Gennady-Kudinov/PA-EW3MM-1kw-TUNER-1kw/README.md

# PA-EW3MM-1kw-TUNER-1kw
  This project of a 1 kW power amplifier was developed by Sergey EW3MM. This project is very easy to repeat, practically does not require special settings. It is very simple and reliable.
You can watch how this power amplifier was assembled and how it works on the channel: 
https://rutube.ru/channel/23993242/videos/
@pa_tuner_1000wt
https://www.youtube.com/@tulacamera/videos

It would be good if programmers join this project and add new features to this power amplifier.
[amp_last.pdf](https://github.com/user-attachments/files/19566176/amp_last.pdf)
