Gennady-Kudinov/PA-EW3MM-1kw-TUNER-1kw/amp_last.pdf

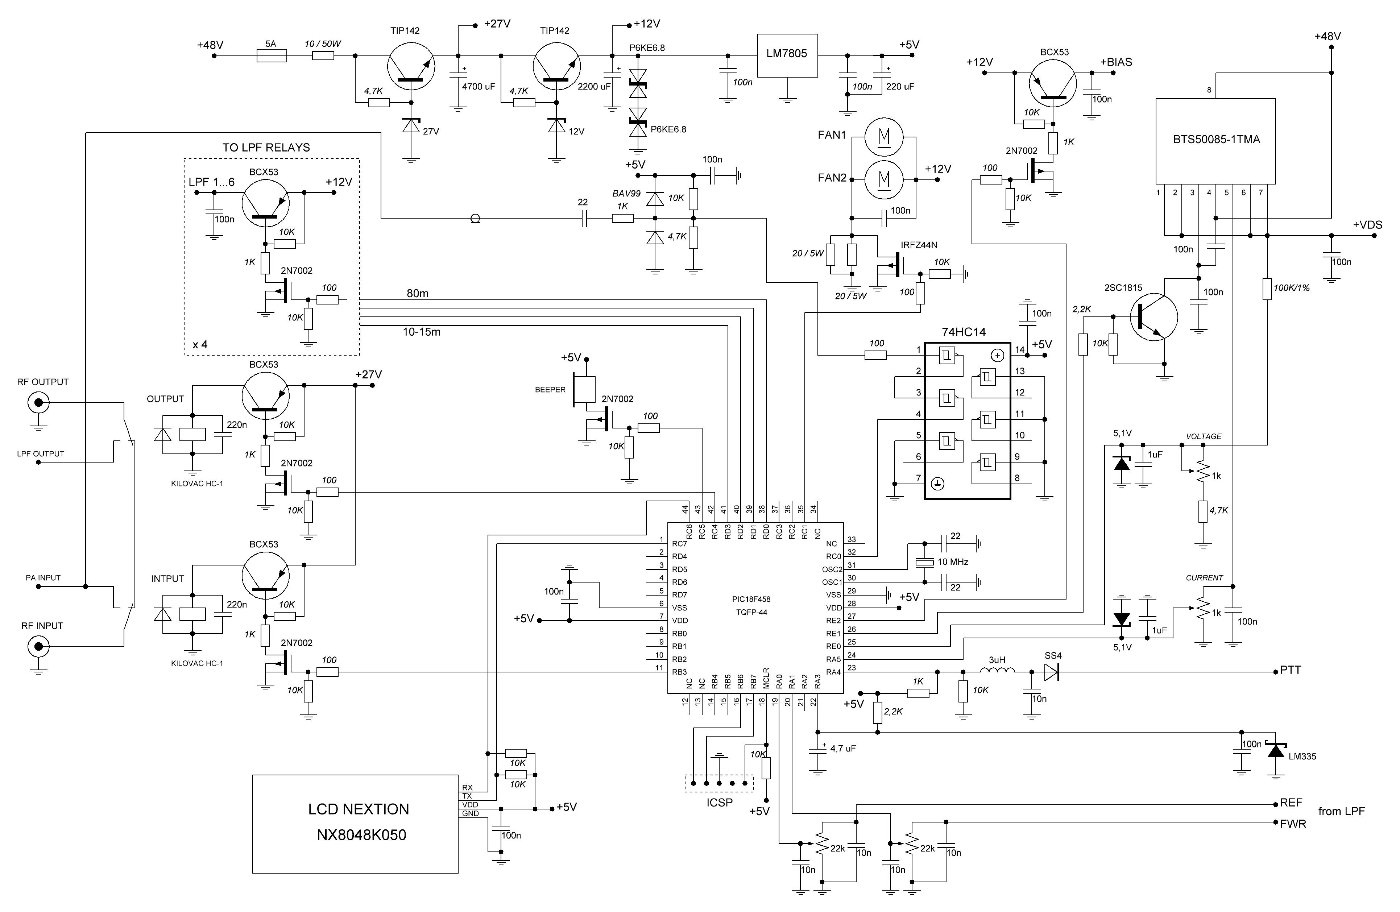
[picture p1: page 1]
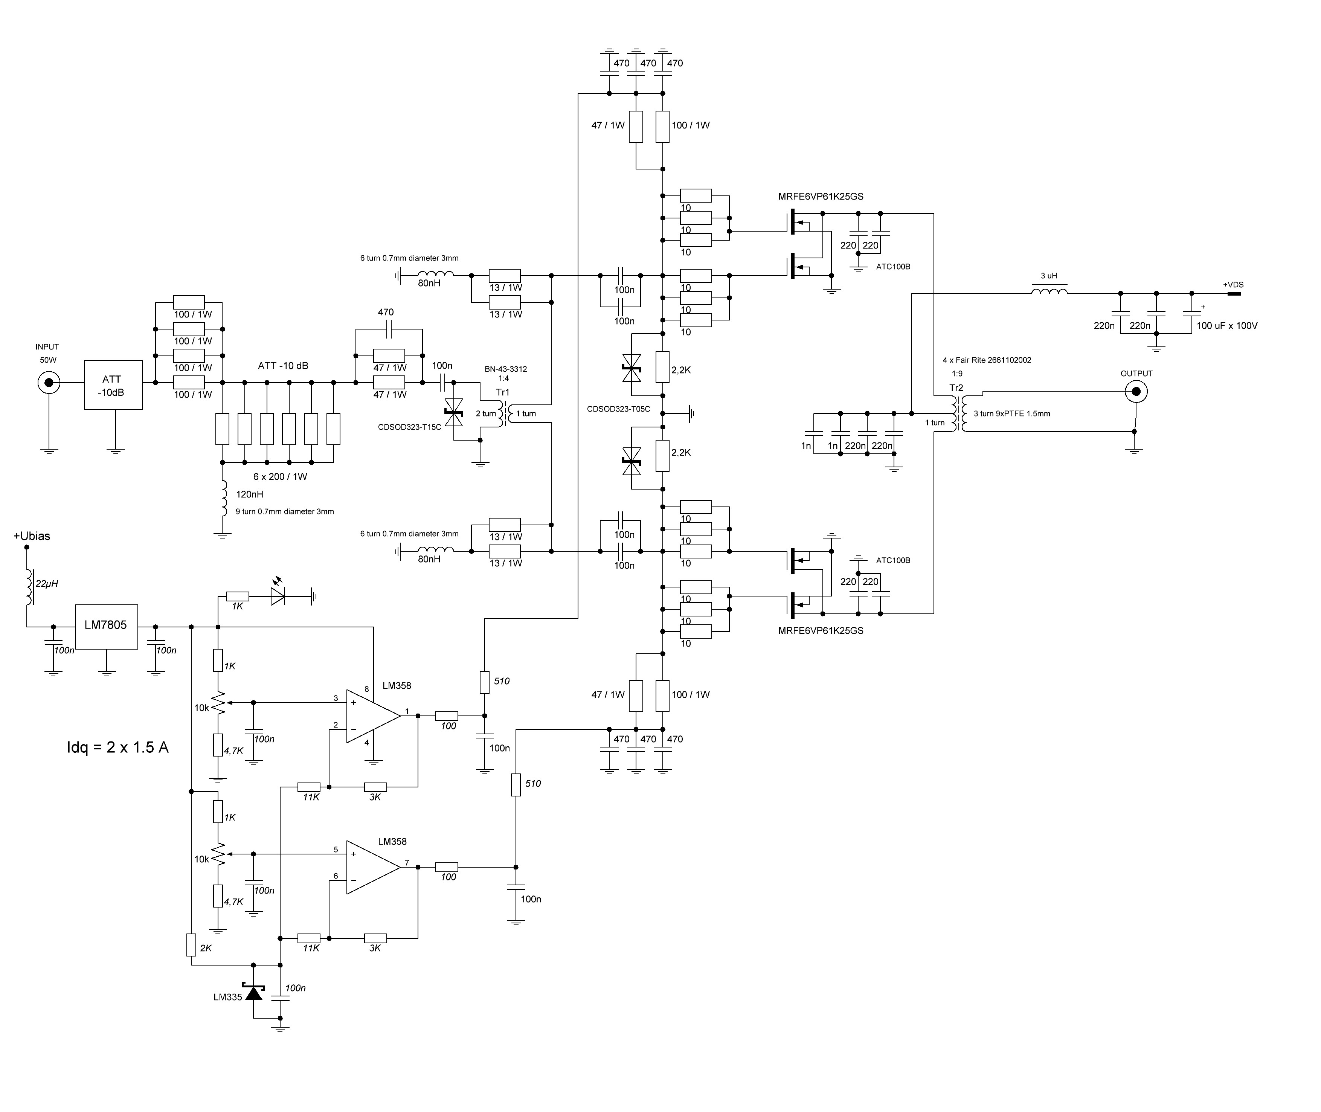
[picture p2: page 2]
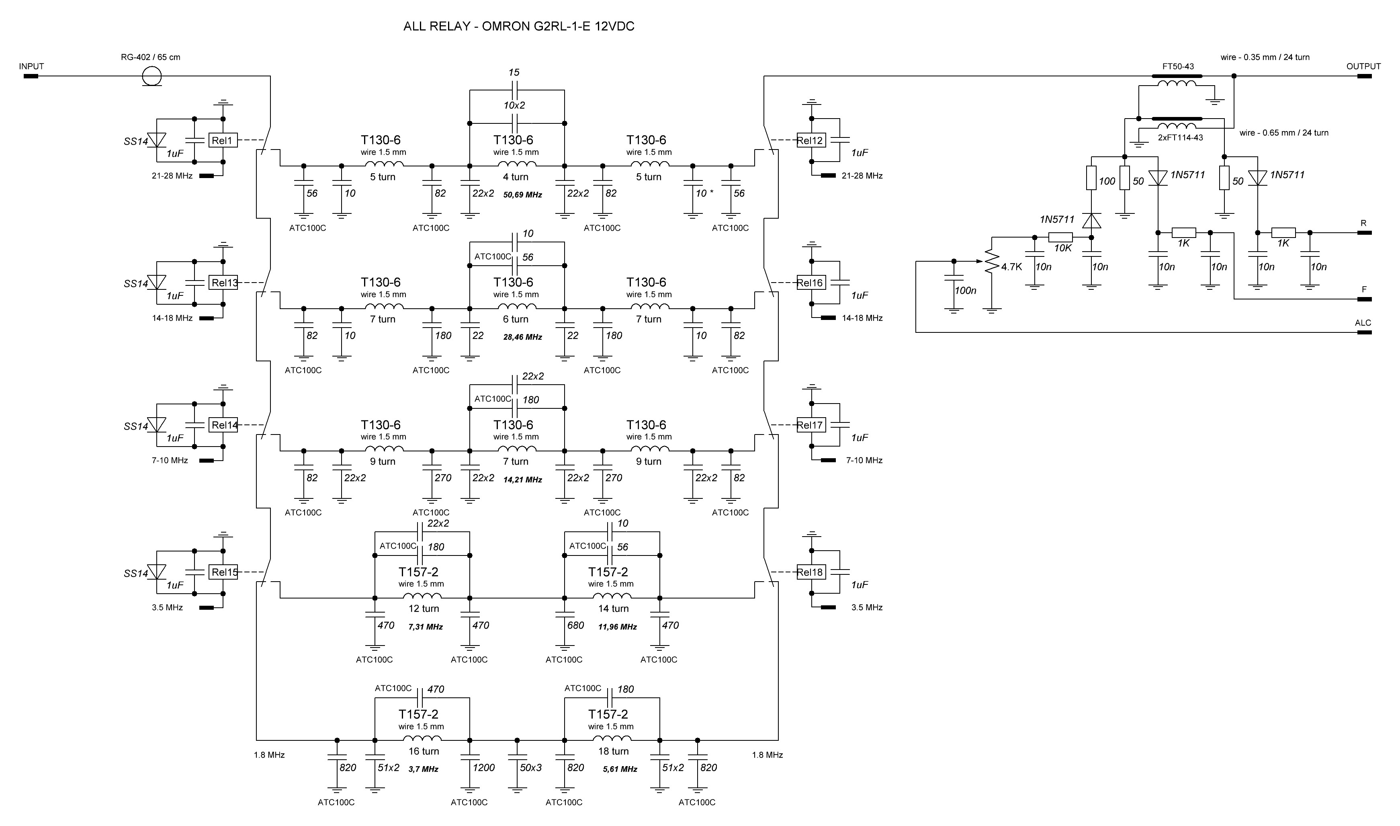
[picture p3: page 3]
