Gennady-Kudinov/PA-EW3MM-1kw-TUNER-1kw/R3BH_Gerber УМ/Детали PA .xlsx

Sheet: БП PA
C1 | = 2200µx25B | 2200µx25B
C2 | = 100n (0805) | 100n | 0805
C3 | = 220µx16B | 220µx16B
C4 | = 100n (0805) | 100n | 0805
C5 | = 100n (1206 100V) | 100n | 1206 100V
C6 | = 100n (1206 100V) | 100n | 1206 100V
C7 | = 100n (1206 100V) | 100n | 1206 100V
F1 | = 5A (FH-102) | 5A | FH-102
PM1 | = LM7805 | LM7805
R1 | = 15/50W (AH-50) | 15/50W | AH-50
R2 | = 4,7k (1210) | 4,7k | 1210
R3 | = 100K 1% (0805) | 100K 1% | 0805
R4 | = 10k (1210) | 10k | 1210
R5 | = 10k (1210) | 10k | 1210
R6 | = 10k (1210) | 10k | 1210
U1 | = BTS50085-1TMA | BTS50085-1TMA
U2 | = BTS50085-1TMA | BTS50085-1TMA
VD1 | = P6KE6.8 (DO-15) | P6KE6.8 | DO-15
VD2 | = BZX384-C12 (SOD-323) | BZX384-C12 | SOD-323
VD3 | = P6KE6.8 (DO-15) | P6KE6.8 | DO-15
VT1 | = TIP142 (TO-247) | TIP142 | TO-247

Sheet: БП PA ver1
БП PA ver1 | C1 | 2200µx25B
БП PA ver1 | C2 | 100n | 0805
БП PA ver1 | C3 | 220µx16B
БП PA ver1 | C4 | 100n | 0805
БП PA ver1 | C5 | 100n | 1206 100V
БП PA ver1 | C6 | 100n | 1206 100V
БП PA ver1 | C7 | 100n | 1206 100V
БП PA ver1 | F1 | 5A | FH-102
БП PA ver1 | PM1 | LM7805
БП PA ver1 | R1 | 15/50W | AH-50
БП PA ver1 | R2 | 4,7k | 1210
БП PA ver1 | R3 | 100K 1% | 0805
БП PA ver1 | R4 | 10k | 1210
БП PA ver1 | R5 | 10k | 1210
БП PA ver1 | R6 | 10k | 1210
БП PA ver1 | U1 | BTS50085-1TMA
БП PA ver1 | U2 | BTS50085-1TMA
БП PA ver1 | VD1 | P6KE6.8 | DO-15
БП PA ver1 | VD2 | BZX384-C12 | SOD-323
БП PA ver1 | VD3 | P6KE6.8 | DO-15
БП PA ver1 | VT1 | TIP142 | TO-247

Sheet: amp_digital3 ver1
amp_digital3 ver1 | BP1 | BEEPER | PB-1224PE-05Q
amp_digital3 ver1 | C1 | 100n | 0805
amp_digital3 ver1 | C2 | 100n | 0805
amp_digital3 ver1 | C3 | 100n | 0805
amp_digital3 ver1 | C4 | 22 | 1206
amp_digital3 ver1 | C5 | 100n | 0805
amp_digital3 ver1 | C6 | 100n | 0805
amp_digital3 ver1 | C7 | 100n | 0805
amp_digital3 ver1 | C8 | 100n | 0805
amp_digital3 ver1 | C9 | 100n | 0805
amp_digital3 ver1 | C10 | 100n | 0805
amp_digital3 ver1 | C11 | 100n | 0805
amp_digital3 ver1 | C12 | 100n | 0805
amp_digital3 ver1 | C13 | 100n 100V | 0805
amp_digital3 ver1 | C14 | 10n | 0805
amp_digital3 ver1 | C15 | 100n | 0805
amp_digital3 ver1 | C16 | 100n | 0805
amp_digital3 ver1 | C17 | 1uF | 0805
amp_digital3 ver1 | C18 | 100n | 0805
amp_digital3 ver1 | C19 | 22 | 0805
amp_digital3 ver1 | C20 | 100n | 0805
amp_digital3 ver1 | C21 | 1uF | 0805
amp_digital3 ver1 | C22 | 100n100V | 0805
amp_digital3 ver1 | C23 | 22 | 0805
amp_digital3 ver1 | C24 | 100n | 0805
amp_digital3 ver1 | C25 | 100n | 0805
amp_digital3 ver1 | C26 | 100n | 0805
amp_digital3 ver1 | C27 | 10n | 0805
amp_digital3 ver1 | C28 | 100n | 0805
amp_digital3 ver1 | C29 | 4,7µx16V | 1206
amp_digital3 ver1 | C30 | 100n | 0805
amp_digital3 ver1 | C31 | 100n | 0805
amp_digital3 ver1 | C32 | 10n | 0805
amp_digital3 ver1 | C33 | 10n | 0805
amp_digital3 ver1 | C34 | 10n | 0805
amp_digital3 ver1 | C35 | 10n | 0805
amp_digital3 ver1 | C36 | 220µx16B
amp_digital3 ver1 | C37 | 100n | 0805
amp_digital3 ver1 | C38 | 220µx25B
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
amp_digital3 ver1 | VT2 | BCX53 | SOT-89
amp_digital3 ver1 | VT3 | BCX53 | SOT-89
amp_digital3 ver1 | VT4 | BCX53 | SOT-89
amp_digital3 ver1 | VT5 | 2SC1815 | SOT-23-3
amp_digital3 ver1 | VT6 | BCX53 | SOT-89
amp_digital3 ver1 | VT7 | BCX53 | SOT-89
amp_digital3 ver1 | VT8 | BCX53 | SOT-89

Sheet: amp_K25_3M
amp_K25_3M | ATT1 | 10db
amp_K25_3M | C1 | 470 | 1206
amp_K25_3M | C2 | 470 | 1206
amp_K25_3M | C3 | 470 | 1206
amp_K25_3M | C4 | 100x2 | 1812
amp_K25_3M | C5 | 120x2 | 1812
amp_K25_3M | C6 | 100n | 1210
amp_K25_3M | C7 | 100n | 1210
amp_K25_3M | C8 | 470 | 1210
amp_K25_3M | C9 | 220n | 1812 100V
amp_K25_3M | C10 | 220n | 1812 100V
amp_K25_3M | C11 | 100µF x 100V
amp_K25_3M | C12 | 100n | 1210
amp_K25_3M | C13 | 1n | 1812 100V
amp_K25_3M | C14 | 1n | 1812 100V
amp_K25_3M | C15 | 220n | 1812 100V
amp_K25_3M | C16 | 220n | 1812 100V
amp_K25_3M | C17 | 100n | 1210
amp_K25_3M | C18 | 100n | 1210
amp_K25_3M | C19 | 100x2 | 1812
amp_K25_3M | C20 | 120x2 | 1812
amp_K25_3M | C21 | 100n | 0805
amp_K25_3M | C22 | 100n | 0805
amp_K25_3M | C23 | 100n | 0805
amp_K25_3M | C24 | 100n | 1210
amp_K25_3M | C25 | 470 | 1206
amp_K25_3M | C26 | 470 | 1206
amp_K25_3M | C27 | 470 | 1206
amp_K25_3M | C28 | 100n | 0805
amp_K25_3M | C29 | 100n | 1210
amp_K25_3M | C30 | 100n | 0805
amp_K25_3M | HL1 | KP-1608SURC | 0603
amp_K25_3M | L1 | 80nH
amp_K25_3M | L2 | 120nH
amp_K25_3M | L3 | 22µH | 1210 CM322522-220KL
amp_K25_3M | L4 | 80nH
amp_K25_3M | L5 | 3uH
amp_K25_3M | R1 | 47/1W | 2512
amp_K25_3M | R2 | 100/1W | 2512
amp_K25_3M | R3 | 10 | 1206
amp_K25_3M | R4 | 10 | 1206
amp_K25_3M | R5 | 10 | 1206
amp_K25_3M | R6 | 13/1W | 2512
amp_K25_3M | R7 | 10 | 1206
amp_K25_3M | R8 | 100/1W | 2512
amp_K25_3M | R9 | 13/1W | 2512
amp_K25_3M | R10 | 10 | 1206
amp_K25_3M | R11 | 100/1W | 2512
amp_K25_3M | R12 | 10 | 1206
amp_K25_3M | R13 | 100/1W | 2512
amp_K25_3M | R14 | 47/1W | 2512
amp_K25_3M | R15 | 2,2k | 1206
amp_K25_3M | R16 | 100/1W | 2512
amp_K25_3M | R17 | 47/1W | 2512
amp_K25_3M | R18 | 200/1W | 2512
amp_K25_3M | R19 | 200/1W | 2512
amp_K25_3M | R20 | 200/1W | 2512
amp_K25_3M | R21 | 200/1W | 2512
amp_K25_3M | R22 | 200/1W | 2512
amp_K25_3M | R23 | 200/1W | 2512
amp_K25_3M | R24 | 2,2k | 1206
amp_K25_3M | R25 | 10 | 1206
amp_K25_3M | R26 | 13/1W | 2512
amp_K25_3M | R27 | 10 | 1206
amp_K25_3M | R28 | 13/1W | 2512
amp_K25_3M | R29 | 10 | 1206
amp_K25_3M | R30 | 1k | 0805
amp_K25_3M | R31 | 10 | 1206
amp_K25_3M | R32 | 510 | 0805
amp_K25_3M | R33 | 10 | 1206
amp_K25_3M | R34 | 10k | 3224X
amp_K25_3M | R35 | 100 | 0805
amp_K25_3M | R36 | 10 | 1206
amp_K25_3M | R37 | 4,7k | 0805
amp_K25_3M | R38 | 47/1W | 2512
amp_K25_3M | R39 | 100/1W | 2512
amp_K25_3M | R40 | 11k | 0805
amp_K25_3M | R41 | 3k | 0805
amp_K25_3M | R42 | 1k | 0805
amp_K25_3M | R43 | 10k | 3224X
amp_K25_3M | R44 | 510 | 0805
amp_K25_3M | R45 | 100 | 0805
amp_K25_3M | R46 | 4,7k | 0805
amp_K25_3M | R47 | 2k | 0805
amp_K25_3M | R48 | 11k | 0805
amp_K25_3M | R49 | 3k | 0805
amp_K25_3M | R50 | 1k | 0805
amp_K25_3M | Tr1 | BN-43-3312
amp_K25_3M | Tr2 | 4 x Fair Rite 2661102002
amp_K25_3M | U1 | LDL1117S50R | TO-223
amp_K25_3M | U2 | LM358 | SOP-8
amp_K25_3M | VD1 | CDSOD323-T05C
amp_K25_3M | VD2 | CDSOD323-T15C
amp_K25_3M | VD3 | CDSOD323-T05C
amp_K25_3M | VD4 | LM335
amp_K25_3M | VT1 | MRFE6VP61K25GS
amp_K25_3M | VT2 | MRFE6VP61K25GS

Sheet: lpf_K25_E ver1
lpf_K25_E ver1 | C1 | 10 | 1812
lpf_K25_E ver1 | C2 | 1uF | 0805
lpf_K25_E ver1 | C3 | 1uF | 0805
lpf_K25_E ver1 | C4 | 10x4 | 1812
lpf_K25_E ver1 | C5 | 10x7 | 1812
lpf_K25_E ver1 | C6 | 27x2 | 1808
lpf_K25_E ver1 | C7 | 27x2 | 1808
lpf_K25_E ver1 | C8 | 10x7 | 1812
lpf_K25_E ver1 | C9 | 10x4 | 1812
lpf_K25_E ver1 | C10 | 10 | 1812
lpf_K25_E ver1 | C11 | 10n | 0805
lpf_K25_E ver1 | C12 | 10n | 0805
lpf_K25_E ver1 | C13 | 10n | 0805
lpf_K25_E ver1 | C14 | 10n | 0805
lpf_K25_E ver1 | C15 | 10n | 0805
lpf_K25_E ver1 | C16 | 10n | 0805
lpf_K25_E ver1 | C17 | 100n | 0805
lpf_K25_E ver1 | C18 | 1uF | 0805
lpf_K25_E ver1 | C19 | 27x2 | 1808
lpf_K25_E ver1 | C20 | 1uF | 0805
lpf_K25_E ver1 | C21 | 10x9 | 1812
lpf_K25_E ver1 | C22 | 27x7 | 1808
lpf_K25_E ver1 | C23 | 10 | 1812
lpf_K25_E ver1 | C24 | 10 | 1812
lpf_K25_E ver1 | C25 | 27x7 | 1808
lpf_K25_E ver1 | C26 | 10x9 | 1812
lpf_K25_E ver1 | C27 | 10x4 | 1812
lpf_K25_E ver1 | C28 | 47x4 | 1812
lpf_K25_E ver1 | C29 | 1uF | 0805
lpf_K25_E ver1 | C30 | 1uF | 0805
lpf_K25_E ver1 | C31 | 100n | 0805
lpf_K25_E ver1 | C32 | 100n | 0805
lpf_K25_E ver1 | C33 | 100n | 0805
lpf_K25_E ver1 | C34 | 100n | 0805
lpf_K25_E ver1 | C35 | 10x7 | 1812
lpf_K25_E ver1 | C36 | 27x2 | 1808
lpf_K25_E ver1 | C37 | 47x5 | 1812
lpf_K25_E ver1 | C38 | 27x3 | 1808
lpf_K25_E ver1 | C39 | 27x3 | 1808
lpf_K25_E ver1 | C40 | 47x5 | 1812
lpf_K25_E ver1 | C41 | 27x2 | 1808
lpf_K25_E ver1 | C42 | 10x7 | 1812
lpf_K25_E ver1 | C43 | 10x4 | 1812
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
lpf_K25_E ver1 | VD2 | SS14
lpf_K25_E ver1 | VD3 | 1N5711
lpf_K25_E ver1 | VD4 | 1N5711
lpf_K25_E ver1 | VD5 | 1N4148*
lpf_K25_E ver1 | VD6 | SS14
lpf_K25_E ver1 | VD7 | SS14
lpf_K25_E ver1 | VD8 | SS14
lpf_K25_E ver1 | VD9 | SS14
lpf_K25_E ver1 | VD10 | SS14
lpf_K25_E ver1 | VD11 | SS14

Sheet: Relays In-Out
Relays In-Out | C1 | 1uF | 0805
Relays In-Out | C2 | 1uF | 0805
Relays In-Out | C3 | 100n | 0805
Relays In-Out | C4 | 100n | 0805
Relays In-Out | FB1 | BLM21
Relays In-Out | FB2 | BLM21
Relays In-Out | HL1 | KP-1608SURC | 0603
Relays In-Out | HL2 | KP-1608SURC | 0603
Relays In-Out | K1 | OMRON G2RL-1E 12VDC
Relays In-Out | K2 | OMRON G2RL-1E 12VDC
Relays In-Out | R1 | 10k | 0805
Relays In-Out | R2 | 10k | 0805
Relays In-Out | VD1 | SS14
Relays In-Out | VD2 | SS14

Sheet: Tuner
Tuner | C1 | 10 | 1812
Tuner | C2 | 10x2 | 1812
Tuner | C3 | 10x5 | 1812
Tuner | C4 | 27x4 | 1812
Tuner | C5 | 120 | 1812
Tuner | C5 | 47x2 | 1812
Tuner | C6 | 120x4 | 1812
Tuner | C7 | 120x2 | 1812
Tuner | C7 | 220x3 | 1812
Tuner | C7 | 47 | 1812
Tuner | C8 | 100n | 0805
Tuner | C9 | 4,7µx16V | 1206
Tuner | C10 | 22 | 0805
Tuner | C11 | 100n | 0805
Tuner | C12 | 1uF | 0805
Tuner | C13 | 22 | 0805
Tuner | C14 | 100n | 0805
Tuner | C15 | 10u | 0805
Tuner | C16 | 4,7µx16V | 1206
Tuner | C17 | 10n | 0805
Tuner | C18 | 100n | 0805
Tuner | C19 | 10n | 0805
Tuner | C20 | 100n | 0805
Tuner | C21 | 1n | 0805
Tuner | C22 | 1n | 0805
Tuner | C23 | 1u | 0805
Tuner | C24 | 1u | 0805
Tuner | C25 | 1u | 0805
Tuner | C26 | 1u | 0805
Tuner | C27 | 1u | 0805
Tuner | C28 | 1u | 0805
Tuner | C29 | 1u | 0805
Tuner | C30 | 100n | 0805
Tuner | C31 | 100n | 0805
Tuner | C32 | 100n | 0805
Tuner | C33 | 100n | 0805
Tuner | C34 | 100n | 0805
Tuner | C35 | 100n | 0805
Tuner | C36 | 100n | 0805
Tuner | C37 | 100nx16 | 0805
Tuner | C38 | 100nx16 | 0805
Tuner | C39 | 100n | 0805
Tuner | C40 | 1u | 0805
Tuner | C41 | 1u | 0805
Tuner | C42 | 100n | 0805
Tuner | C43 | 1u | 0805
Tuner | C44 | 100n | 0805
Tuner | C45 | 1u | 0805
Tuner | C46 | 100n | 0805
Tuner | C47 | 1u | 0805
Tuner | C48 | 100n | 0805
Tuner | C49 | 1u | 0805
Tuner | C50 | 100n | 0805
Tuner | C51 | 1u | 0805
Tuner | C52 | 100n | 0805
Tuner | C53 | 1u | 0805
Tuner | C54 | 100n | 0805
Tuner | C55 | 1uF | 0805
Tuner | C56 | 220µx16B
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
Tuner | VD10 | SS14
Tuner | VD11 | SS14 | 0603
Tuner | VD12 | SS14
Tuner | VD13 | SS14
Tuner | VD14 | SS14
Tuner | VD15 | SS14
Tuner | VD16 | SS14
Tuner | VD17 | SS14
Tuner | VD18 | SS14
Tuner | VR1 | B0505S-1W
Tuner | VT1 | 2N7002
Tuner | VT2 | 2N7002
Tuner | VT3 | BCX53x16 | SOT-89

Sheet: FULL
БП PA ver1 | C1 | 2200µx25B
БП PA ver1 | C2 | 100n | 0805
БП PA ver1 | C3 | 220µx16B
БП PA ver1 | C4 | 100n | 0805
БП PA ver1 | C5 | 100n | 1206 100V
БП PA ver1 | C6 | 100n | 1206 100V
БП PA ver1 | C7 | 100n | 1206 100V
БП PA ver1 | F1 | 5A | FH-102
БП PA ver1 | PM1 | LM7805
БП PA ver1 | R1 | 15/50W | AH-50
БП PA ver1 | R2 | 4,7k | 1210
БП PA ver1 | R3 | 100K 1% | 0805
БП PA ver1 | R4 | 10k | 1210
БП PA ver1 | R5 | 10k | 1210
БП PA ver1 | R6 | 10k | 1210
БП PA ver1 | U1 | BTS50085-1TMA
БП PA ver1 | U2 | BTS50085-1TMA
БП PA ver1 | VD1 | P6KE6.8 | DO-15
БП PA ver1 | VD2 | BZX384-C12 | SOD-323
БП PA ver1 | VD3 | P6KE6.8 | DO-15
БП PA ver1 | VT1 | TIP142 | TO-247
amp_digital3 ver1 | BP1 | BEEPER | PB-1224PE-05Q
amp_digital3 ver1 | C1 | 100n | 0805
amp_digital3 ver1 | C2 | 100n | 0805
amp_digital3 ver1 | C3 | 100n | 0805
amp_digital3 ver1 | C4 | 22 | 1206
amp_digital3 ver1 | C5 | 100n | 0805
amp_digital3 ver1 | C6 | 100n | 0805
amp_digital3 ver1 | C7 | 100n | 0805
amp_digital3 ver1 | C8 | 100n | 0805
amp_digital3 ver1 | C9 | 100n | 0805
amp_digital3 ver1 | C10 | 100n | 0805
amp_digital3 ver1 | C11 | 100n | 0805
amp_digital3 ver1 | C12 | 100n | 0805
amp_digital3 ver1 | C13 | 100n 100V | 0805
amp_digital3 ver1 | C14 | 10n | 0805
amp_digital3 ver1 | C15 | 100n | 0805
amp_digital3 ver1 | C16 | 100n | 0805
amp_digital3 ver1 | C17 | 1uF | 0805
amp_digital3 ver1 | C18 | 100n | 0805
amp_digital3 ver1 | C19 | 22 | 0805
amp_digital3 ver1 | C20 | 100n | 0805
amp_digital3 ver1 | C21 | 1uF | 0805
amp_digital3 ver1 | C22 | 100n100V | 0805
amp_digital3 ver1 | C23 | 22 | 0805
amp_digital3 ver1 | C24 | 100n | 0805
amp_digital3 ver1 | C25 | 100n | 0805
amp_digital3 ver1 | C26 | 100n | 0805
amp_digital3 ver1 | C27 | 10n | 0805
amp_digital3 ver1 | C28 | 100n | 0805
amp_digital3 ver1 | C29 | 4,7µx16V | 1206
amp_digital3 ver1 | C30 | 100n | 0805
amp_digital3 ver1 | C31 | 100n | 0805
amp_digital3 ver1 | C32 | 10n | 0805
amp_digital3 ver1 | C33 | 10n | 0805
amp_digital3 ver1 | C34 | 10n | 0805
amp_digital3 ver1 | C35 | 10n | 0805
amp_digital3 ver1 | C36 | 220µx16B
amp_digital3 ver1 | C37 | 100n | 0805
amp_digital3 ver1 | C38 | 220µx25B
amp_digital3 ver1 | C39 | 100n | 0805
amp_digital3 ver1 | C40 | 100n 100V | 0805
amp_digital3 ver1 | C41 | 4,7µx16V | 1206
amp_digital3 ver1 | C42 | 4,7µx16V | 1206
amp_digital3 ver1 | C43 | 100n | 0805
amp_digital3 ver1 | Cr1 | 10 MHz
amp_digital3 ver1 | FB1 | BLM21
amp_digital3 ver1 | FB2 | BLM21
amp_digital3 ver1 | FB3 | BLM21
amp_digital3 ver1 | FB4 | BLM21
amp_digital3 ver1 | FB5 | BLM21
amp_digital3 ver1 | FB6 | BLM21
amp_digital3 ver1 | FB7 | BLM21
amp_digital3 ver1 | FB8 | BLM21
amp_digital3 ver1 | FB9 | BLM21
amp_digital3 ver1 | FB10 | BLM21
amp_digital3 ver1 | L1 | 3uH | 0805 LQM21NN3R3K10L
amp_digital3 ver1 | PM1 | mini360
amp_digital3 ver1 | R1 | 10k | 0805
amp_digital3 ver1 | R2 | 10k | 0805
amp_digital3 ver1 | R3 | 1k | 0805
amp_digital3 ver1 | R4 | 100 | 0805
amp_digital3 ver1 | R5 | 1k | 0805
amp_digital3 ver1 | R6 | 4.7k | 0805
amp_digital3 ver1 | R7 | 100 | 0805
amp_digital3 ver1 | R8 | 10k | 0805
amp_digital3 ver1 | R9 | 10k | 0805
amp_digital3 ver1 | R10 | 10k | 0805
amp_digital3 ver1 | R11 | 1k | 0805
amp_digital3 ver1 | R12 | 1k | 0805
amp_digital3 ver1 | R13 | 100 | 0805
amp_digital3 ver1 | R14 | 10k | 0805
amp_digital3 ver1 | R15 | 100 | 0805
amp_digital3 ver1 | R16 | 10k | 0805
amp_digital3 ver1 | R17 | 20/5W
amp_digital3 ver1 | R18 | 20/5W
amp_digital3 ver1 | R19 | 100 | 0805
amp_digital3 ver1 | R20 | 10k | 0805
amp_digital3 ver1 | R21 | 10k | 0805
amp_digital3 ver1 | R22 | 2,2k | 0805
amp_digital3 ver1 | R23 | 1k | 0805
amp_digital3 ver1 | R24 | 100 | 0805
amp_digital3 ver1 | R25 | 10k | 0805
amp_digital3 ver1 | R26 | 100 | 0805
amp_digital3 ver1 | R27 | 10k | 0805
amp_digital3 ver1 | R28 | 10k | 0805
amp_digital3 ver1 | R29 | 10k | 0805
amp_digital3 ver1 | R30 | 1k | 3296X
amp_digital3 ver1 | R31 | 1k | 0805
amp_digital3 ver1 | R32 | 100 | 0805
amp_digital3 ver1 | R33 | 4,7k | 0805
amp_digital3 ver1 | R34 | 10k | 0805
amp_digital3 ver1 | R35 | 1k | 3296X
amp_digital3 ver1 | R36 | 10k | 0805
amp_digital3 ver1 | R37 | 1k | 0805
amp_digital3 ver1 | R38 | 100 | 0805
amp_digital3 ver1 | R39 | 10k | 0805
amp_digital3 ver1 | R40 | 10k | 0805
amp_digital3 ver1 | R41 | 4,7k | 0805
amp_digital3 ver1 | R42 | 10k | 0805
amp_digital3 ver1 | R43 | 1k | 0805
amp_digital3 ver1 | R44 | 100 | 0805
amp_digital3 ver1 | R45 | 2,2k | 0805
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
Tuner | R32 | 10k | 0805
Tuner | R33 | 10k | 0805
Tuner | R34 | 10k | 0805
Tuner | R35 | 10k | 0805
Tuner | T1 | PC817
Tuner | T2 | PC817
Tuner | T3 | 2N7002x16 | SOT-23
Tuner | TR1 | FT50-43
Tuner | TR2 | 2xFT82-43
Tuner | U1 | PIC18F458 | TQFP44
Tuner | VD1 | SS14
Tuner | VD2 | 1N5711
Tuner | VD3 | 1N5711
Tuner | VD4 | SS14
Tuner | VD5 | SS14
Tuner | VD6 | SS14
Tuner | VD7 | SS14
Tuner | VD8 | SS14
Tuner | VD9 | SS14
Tuner | VD10 | SS14
Tuner | VD11 | SS14 | 0603
Tuner | VD12 | SS14
Tuner | VD13 | SS14
Tuner | VD14 | SS14
Tuner | VD15 | SS14
Tuner | VD16 | SS14
Tuner | VD17 | SS14
Tuner | VD18 | SS14
Tuner | VR1 | B0505S-1W
Tuner | VT1 | 2N7002
Tuner | VT2 | 2N7002
Tuner | VT3 | BCX53x16 | SOT-89

Sheet: Резистор
amp_digital3 ver1 | R17 | 20/5W |  | 2
amp_digital3 ver1 | R4 | 100 | 0805 | 12 | https://www.electronshik.ru/item/YAG/RC0805JR-07100RL | https://www.electronshik.ru/item/YAG/RC0805JR-07100RL
БП PA ver1 | R3 | 100K 1% | 0805 | 1 |  | https://www.electronshik.ru/item/YAG/RT0805BRD07100KL
amp_digital3 ver1 | R1 | 10k | 0805 | 92 |  | https://www.electronshik.ru/item/YAG/RC0805JR-0710KL
Tuner | R26 | 10x16 | 0805 | 16 |  | https://www.electronshik.ru/item/YAG/RC0805JR-0710RL
amp_K25_3M | R40 | 11k | 0805 | 2 |  | https://www.electronshik.ru/item/YAG/RC0805JR-0711KL
amp_digital3 ver1 | R3 | 1k | 0805 | 32 |  | https://www.electronshik.ru/item/YAG/RC0805JR-071KL
amp_digital3 ver1 | R22 | 2,2k | 0805 | 2 |  | https://www.electronshik.ru/item/YAG/RC0805JR-072K2L
Tuner | R8 | 22k | 0805 | 2 |  | https://www.electronshik.ru/item/YAG/RC0805JR-0722KL
amp_K25_3M | R47 | 2k | 0805 | 1 |  | https://www.electronshik.ru/item/YAG/RC0805JR-072KL
amp_K25_3M | R41 | 3k | 0805 | 2 |  | https://www.electronshik.ru/item/YAG/RC0805JR-073KL
amp_digital3 ver1 | R33 | 4,7k | 0805 | 6 |  | https://www.electronshik.ru/item/YAG/RC0805JR-074K7L
amp_K25_3M | R32 | 510 | 0805 | 4 |  | https://www.electronshik.ru/item/YAG/RC0805JR-07510RL
amp_K25_3M | R3 | 10 | 1206 | 12 |  | https://www.electronshik.ru/item/YAG/RC1206JR-0710RL
lpf_K25_E ver1 | R3 | 100 | 1206 | 1 |  | https://www.electronshik.ru/item/YAG/RC1206JR-07100RL
amp_K25_3M | R15 | 2,2k | 1206 | 2 |  | https://www.electronshik.ru/item/YAG/RC1206JR-072K2L
БП PA ver1 | R4 | 10k | 1210 | 3 |  | https://www.electronshik.ru/item/YAG/RC1210JR-0710KL
БП PA ver1 | R2 | 4,7k | 1210 | 1 |  | https://www.electronshik.ru/item/YAG/RC1210JR-074K7L
amp_K25_3M | R2 | 100/1W | 2512 | 14 |  | https://www.electronshik.ru/item/YAG/RC2512JK-07100RL
Tuner | R9 | 10k | 2512 | 2 |  | https://www.electronshik.ru/item/YAG/RC2512JK-0710KL
amp_K25_3M | R6 | 13/1W | 2512 | 4 |  | https://www.electronshik.ru/item/YAG/RC2512JK-0713RL
amp_K25_3M | R18 | 200/1W | 2512 | 6 |  | https://www.electronshik.ru/item/YAG/RC2512JK-07200RL
amp_K25_3M | R1 | 47/1W | 2512 | 4 |  | https://www.electronshik.ru/item/YAG/RC2512JK-0747RL
amp_K25_3M | R34 | 10k | 3224X | 2
lpf_K25_E ver1 | R6 | 10k* | 3296W | 1 |  | https://www.electronshik.ru/item/RUICHI/3296W%2010K
amp_digital3 ver1 | R30 | 1k | 3296X | 2 |  | https://aliexpress.ru/item/4000643862485.html?sku_id=10000004835612543
amp_digital3 ver1 | R50 | 22k | 3296X | 2 |  | https://aliexpress.ru/item/4000643862485.html?sku_id=10000004835612543
БП PA ver1 | R1 | 15/50W | AH-50 | 1

Sheet: Конденсатор
amp_K25_3M | C11 | 100µF x 100V |  | 1 |  | https://www.electronshik.ru/item/PAN/EEVFK2A101M | https://www.electronshik.ru/item/PAN/EEVFK2A101M
БП PA ver1 | C3 | 220µx16B |  | 1 | 2 | https://s-10mitino.ru/s-10/position/?pos=100019285 | https://s-10mitino.ru/s-10/position/?pos=100019285
amp_digital3 ver1 | C36 | 220µx16B | 220µx25B | 4 |  | https://www.electronshik.ru/item/PAN/EEEFK1E221P | https://www.electronshik.ru/item/PAN/EEEFK1E221P
БП PA ver1 | C1 | 2200µx25B |  | 1 |  | https://s-10mitino.ru/s-10/position/?pos=100019502 | https://s-10mitino.ru/s-10/position/?pos=100019502
БП PA ver1 | C2 | 100n | 0805 | 92 |  | https://www.electronshik.ru/item/YAG/CC0805KRX7R9BB104 | https://www.electronshik.ru/item/YAG/CC0805KRX7R9BB104
amp_digital3 ver1 | C13 | 100n 100V | 1206 100V | 8 |  | https://www.electronshik.ru/item/MUR/GRM31CR72E104KW03L | https://www.electronshik.ru/item/MUR/GRM31CR72E104KW03L
amp_digital3 ver1 | C14 | 10n | 0805 | 14 |  | https://www.electronshik.ru/item/YAG/CC0805JRX7R9BB103 | https://www.electronshik.ru/item/YAG/CC0805JRX7R9BB103
Tuner | C15 | 10u | 0805 | 1 |  | https://www.electronshik.ru/item/MUR/GRM21BR61E106KA73L | https://www.electronshik.ru/item/MUR/GRM21BR61E106KA73L
Tuner | C21 | 1n | 0805 | 2 |  | https://www.electronshik.ru/item/YAG/CC0805JRNPO9BN102 | https://www.electronshik.ru/item/YAG/CC0805JRNPO9BN102
Tuner | C23 | 1u | 0805 | 29 |  | https://www.electronshik.ru/item/YAG/CC0805KKX7R9BB105 | https://www.electronshik.ru/item/YAG/CC0805KKX7R9BB105
amp_digital3 ver1 | C19 | 22 | 0805 | 5 |  | https://www.electronshik.ru/item/YAG/CC0805FRNPO9BN220 | https://www.electronshik.ru/item/YAG/CC0805FRNPO9BN220
amp_digital3 ver1 | C29 | 4,7µx16V | Корпус B 6,8µx25V | 5 |  | https://www.electronshik.ru/item/XIANGYEE/CA45-B025K685T | https://www.electronshik.ru/item/XIANGYEE/CA45-B025K685T
amp_K25_3M | C1 | 470 | 1206 | 7 |  | https://www.electronshik.ru/item/YAG/CC1206JRNPOBBN471 | https://www.electronshik.ru/item/YAG/CC1206JRNPOBBN471
amp_K25_3M | C6 | 100n | 1210 | 5 |  | https://www.electronshik.ru/item/MUR/GRM32DR72H104KW10L | https://www.electronshik.ru/item/MUR/GRM32DR72H104KW10L
lpf_K25_E ver1 | C61 | 27 | 1808 | 39 | 40 | https://aliexpress.ru/item/1005006794903535.html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 | https://aliexpress.ru/item/1005006794903535.html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 | 428.00
lpf_K25_E ver1 | C1 | 10 | 1812 | 75 |  | https://www.electronshik.ru/item/YAG/CC1812JKNPOEBN100 | https://www.electronshik.ru/item/YAG/CC1812JKNPOEBN100
amp_K25_3M | C4 | 100x2 | 1812 | 15 |  | https://www.electronshik.ru/item/TDK/C4532C0G3F101K160KA | https://www.electronshik.ru/item/TDK/C4532C0G3F101K160KA
Tuner | C5 | 120 | 1812 | 27 | 30 | https://www.platan.ru/cgi-bin/qwery.pl/id=2015760465 | https://www.platan.ru/cgi-bin/qwery.pl/id=2015760465
Tuner | C7 | 220x3 | 1812 | 13 | 20 | https://www.platan.ru/cgi-bin/qwery.pl/id=2015696927 | https://www.platan.ru/cgi-bin/qwery.pl/id=2015696927
Tuner | C7 | 47 | 1812 | 55 | 60 | https://www.platan.ru/cgi-bin/qwery.pl/id=2015760466 | https://www.platan.ru/cgi-bin/qwery.pl/id=2015760466
amp_K25_3M | C13 | 1n | 1812 100V | 2 |  | https://www.electronshik.ru/item/YAG/CC1812JKNPODBN102 | https://www.electronshik.ru/item/YAG/CC1812JKNPODBN102
amp_K25_3M | C9 | 220n | 1812 100V | 4 |  | https://www.electronshik.ru/item/MUR/GRM43DR72H224KW10L | https://www.electronshik.ru/item/MUR/GRM43DR72H224KW10L

Sheet: Диоды
lpf_K25_E ver1 | VD5 | 1N4148* | DO-35 | 1 |  | https://www.electronshik.ru/item/ONS-FAIR/1N4148TA
lpf_K25_E ver1 | VD3 | 1N5711 | DO-35 | 4 |  | https://www.electronshik.ru/item/ST/1N5711
amp_digital3 ver1 | VD1 | BAV99 | SOT-23 | 1 |  | https://www.electronshik.ru/item/NEX-NXP/BAV99.215
БП PA ver1 | VD2 | BZX384-C12 | SOD-323 | 1 |  | https://www.electronshik.ru/item/NEX-NXP/BZX384-C12.115
amp_digital3 ver1 | VD2 | BZX384-C5V1 | SOD-323 | 2 |  | https://www.electronshik.ru/item/NEX-NXP/BZX384-C5V1.115
amp_K25_3M | VD1 | CDSOD323-T05C |  | 2 |  | https://www.electronshik.ru/item/TECH%20PUB/CDSOD323-T05C
amp_K25_3M | VD2 | CDSOD323-T15C |  | 1 |  | https://www.electronshik.ru/item/LEIDITEH/CDSOD323-T15C
amp_K25_3M | HL1 | KP-1608SURC | 0603 | 4 |  | https://www.electronshik.ru/item/KGB/KP-1608SURC
Tuner | HL2 | KP-1608ZGC | 0603 | 31 | 30 | https://www.electronshik.ru/item/KGB/KP-1608ZGC
amp_digital3 ver1 | VD5 | LM335 | TO-92 | 2 |  | https://www.electronshik.ru/item/ST/LM335Z
БП PA ver1 | VD1 | P6KE6.8 | DO-15 | 2 |  | https://www.platan.ru/cgi-bin/qwery.pl/id=901031466
lpf_K25_E ver1 | VD1 | SS14 |  | 26+1 |  | https://www.electronshik.ru/item/JSCJ/DSS14
amp_digital3 ver1 | VD4 | SS4 | DO-214AC/SMA

Sheet: Транзист
amp_digital3 ver1 | T1 | 2N7002 | SOT-23 | 26 | https://www.electronshik.ru/item/YJ/2N7002 | https://www.electronshik.ru/item/YJ/2N7002
amp_digital3 ver1 | VT5 | 2SC1815 | SOT-23-3 | 1 | https://www.chipdip.ru/product/2sc1815-hottech | https://www.chipdip.ru/product/2sc1815-hottech
amp_digital3 ver1 | VT1 | BCX53 | SOT-89 | 23 | https://www.electronshik.ru/item/NEX-NXP/BCX53.115 | https://www.electronshik.ru/item/NEX-NXP/BCX53.115
amp_digital3 ver1 | T3 | IRFZ44N | TO-263 | 1 | https://www.chipdip.ru/product/irfz44ns?from=suggest_product | https://www.chipdip.ru/product/irfz44ns?from=suggest_product
amp_K25_3M | VT1 | MRFE6VP61K25GS |  | 2 | https://www.chipdip.ru/product0/8023500601 | https://www.chipdip.ru/product0/8023500601 | 28980.00
Tuner | T1 | PC817 | SOP-4 | 2 | https://www.platan.ru/cgi-bin/qwery.pl/id=2016115668 | https://www.platan.ru/cgi-bin/qwery.pl/id=2016115668 | 3643.95
БП PA ver1 | VT1 | TIP142 | TO-247 | 1 | https://s-10mitino.ru/s-10/position/?pos=100017329

Sheet: Микросх
amp_digital3 ver1 | U1 | 74HC14 | SO-14 | 1 |  | https://www.platan.ru/cgi-bin/qwery.pl/id=2016855175
amp_K25_3M | U1 | LDL1117S50R | TO-223 | 1 |  | https://www.chipdip.ru/product/ldl1117s50r
БП PA ver1 | U1 | BTS50085-1TMA |  | 1 |  | https://www.platan.ru/cgi-bin/qwery.pl/id=2010990973
amp_K25_3M | U2 | LM358 | SOP-8 | 1 |  | https://www.electronshik.ru/item/JSMICRO/LM358
БП PA ver1 | PM1 | LM7805 |  | 1 | 2 | https://www.electronshik.ru/item/CDIL/LM7805
amp_digital3 ver1 | U2 | PIC18F458 | TQFP44 | 2

Sheet: Индукт+Рел
amp_K25_3M | L2 | 120nH |  | 1
amp_K25_3M | L3 | 22µH | 1210 CM322522-220KL | 1 | https://www.electronshik.ru/item/BOURNS/CM322522-220KL
amp_digital3 ver1 | L1 | 3uH | 0805 LQM21NN3R3K10L | 1 | https://www.electronshik.ru/item/MUR/LQM21NN3R3K10L
amp_K25_3M | L5 | 3uH | B64290-L618-X87,N87 R25x15x10 | 1 | https://www.chipdip.ru/product/b64290-l618-x87
amp_digital3 ver1 | FB1 | BLM21 |  | 59 | https://www.electronshik.ru/item/MUR/BLM21PG331SH1D
lpf_K25_E ver1 | K1 | OMRON G2RL-1E 12VDC |  | 27 | https://www.electronshik.ru/item/OMRON/G2RL1E12DC
 |  | 2661102002, Ферритовый фильтр |  | 5

Sheet: Разное
БП PA ver1 | F1 | 5A | FH-102 | 1
amp_digital3 ver1 | Cr1 | 10 MHz | HC-49S | 2 | https://www.electronshik.ru/item/SJK/SJK-6B-10.000-16-30-50-B-50-H
amp_K25_3M | ATT1 | 10db |  | 1
Tuner | VR1 | B0505S-1W |  | 1 | https://www.electronshik.ru/item/DEXU/B0505S-1W
amp_digital3 ver1 | BP1 | BEEPER | TMB09A05 5 в | 1 | https://aliexpress.ru/item/1005003915978878.html?sku_id=12000027458636865
amp_digital3 ver1 | PM1 | mini360 |  | 2
Tuner | PM1 | mini360
 |  | LCD NEXTION NX8048K050 |  | 1
