Gennady-Kudinov/PA-EW3MM-1kw-TUNER-1kw/(list of files, cad)

Other CAD files:
2xK25_AMP_ALL_PROJECT/pic18f458_X_8.1/protectx.X/dist/default/production/protectx.X.production.obj
UA4HNU_version/pic18f458_X_8.1_UA4HNU/protectx.X/dist/default/production/protectx.X.production.obj
