Gennady-Kudinov/PA-EW3MM-1kw-TUNER-1kw/R3BH_Gerber УМ/amp_digital3 ver1.pdf

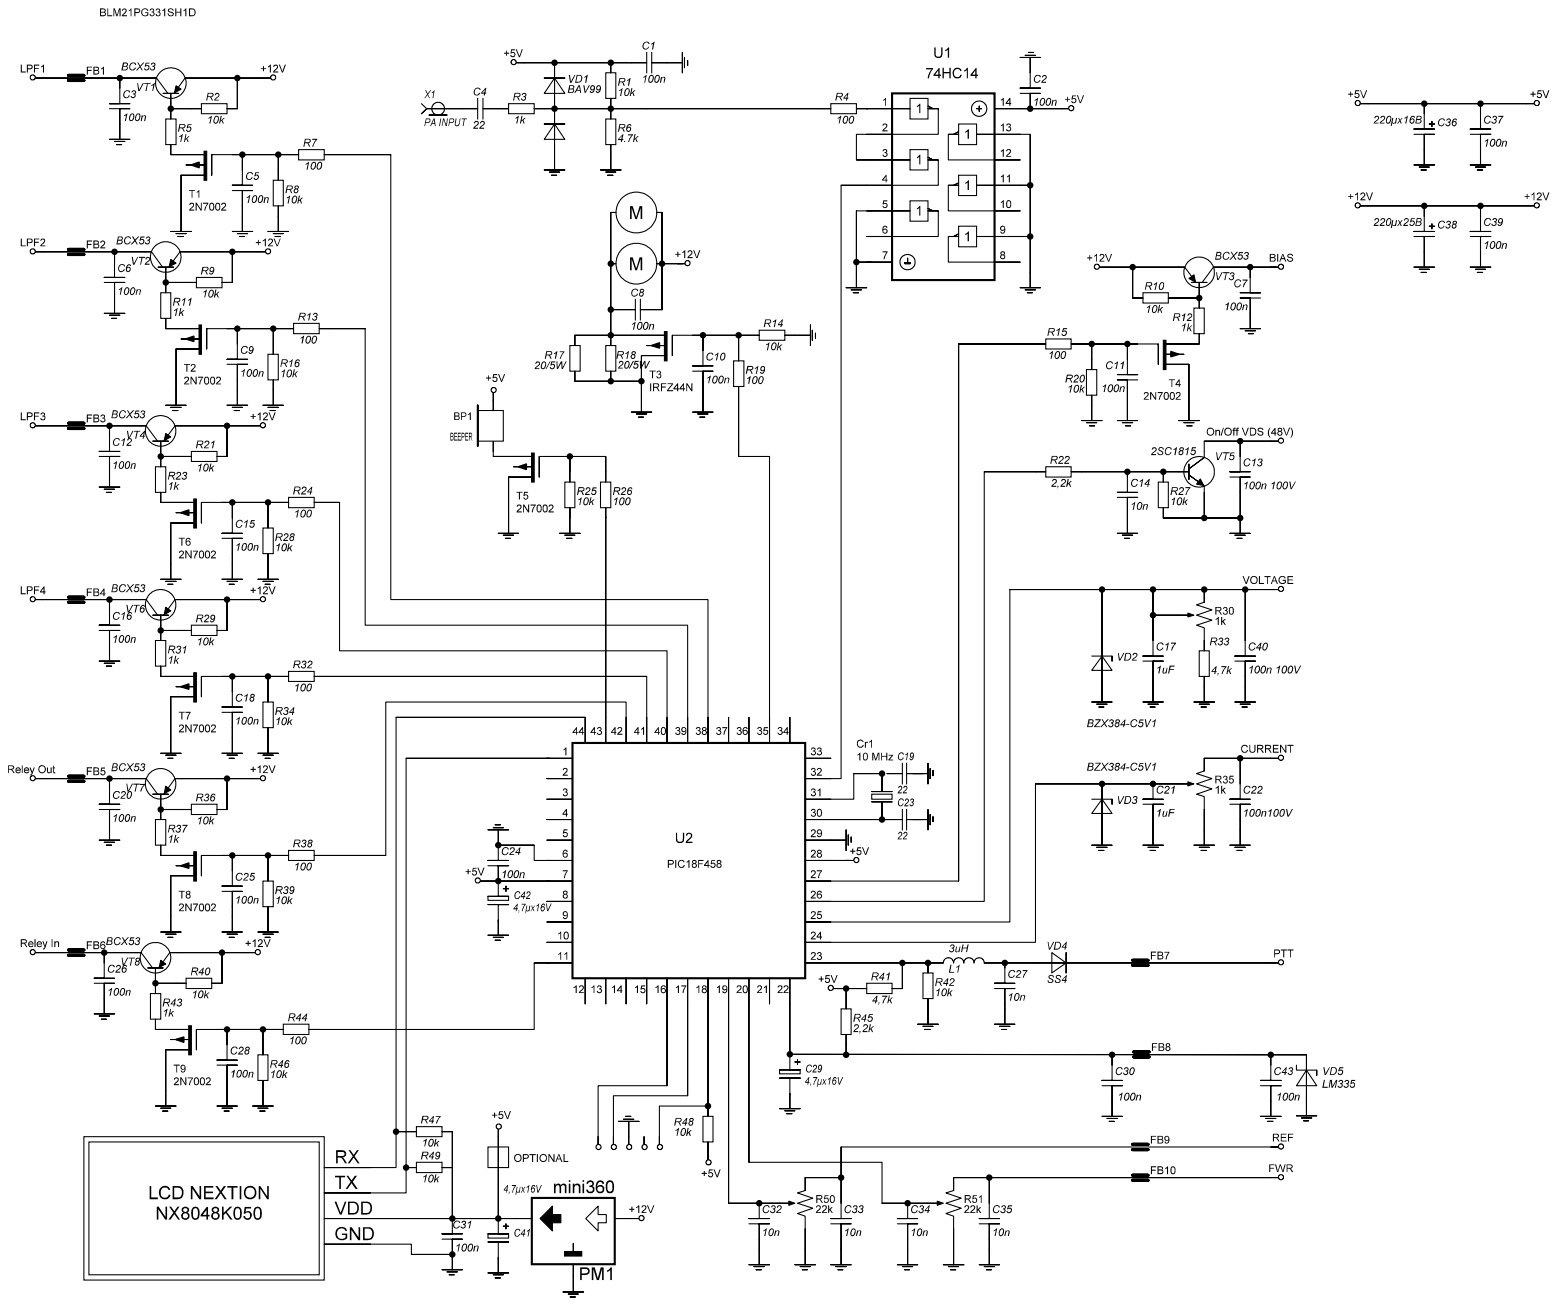
[picture p4: page 1]
