Gennady-Kudinov/PA-EW3MM-1kw-TUNER-1kw/R3BH_Gerber УМ/amp_K25_3M.pdf

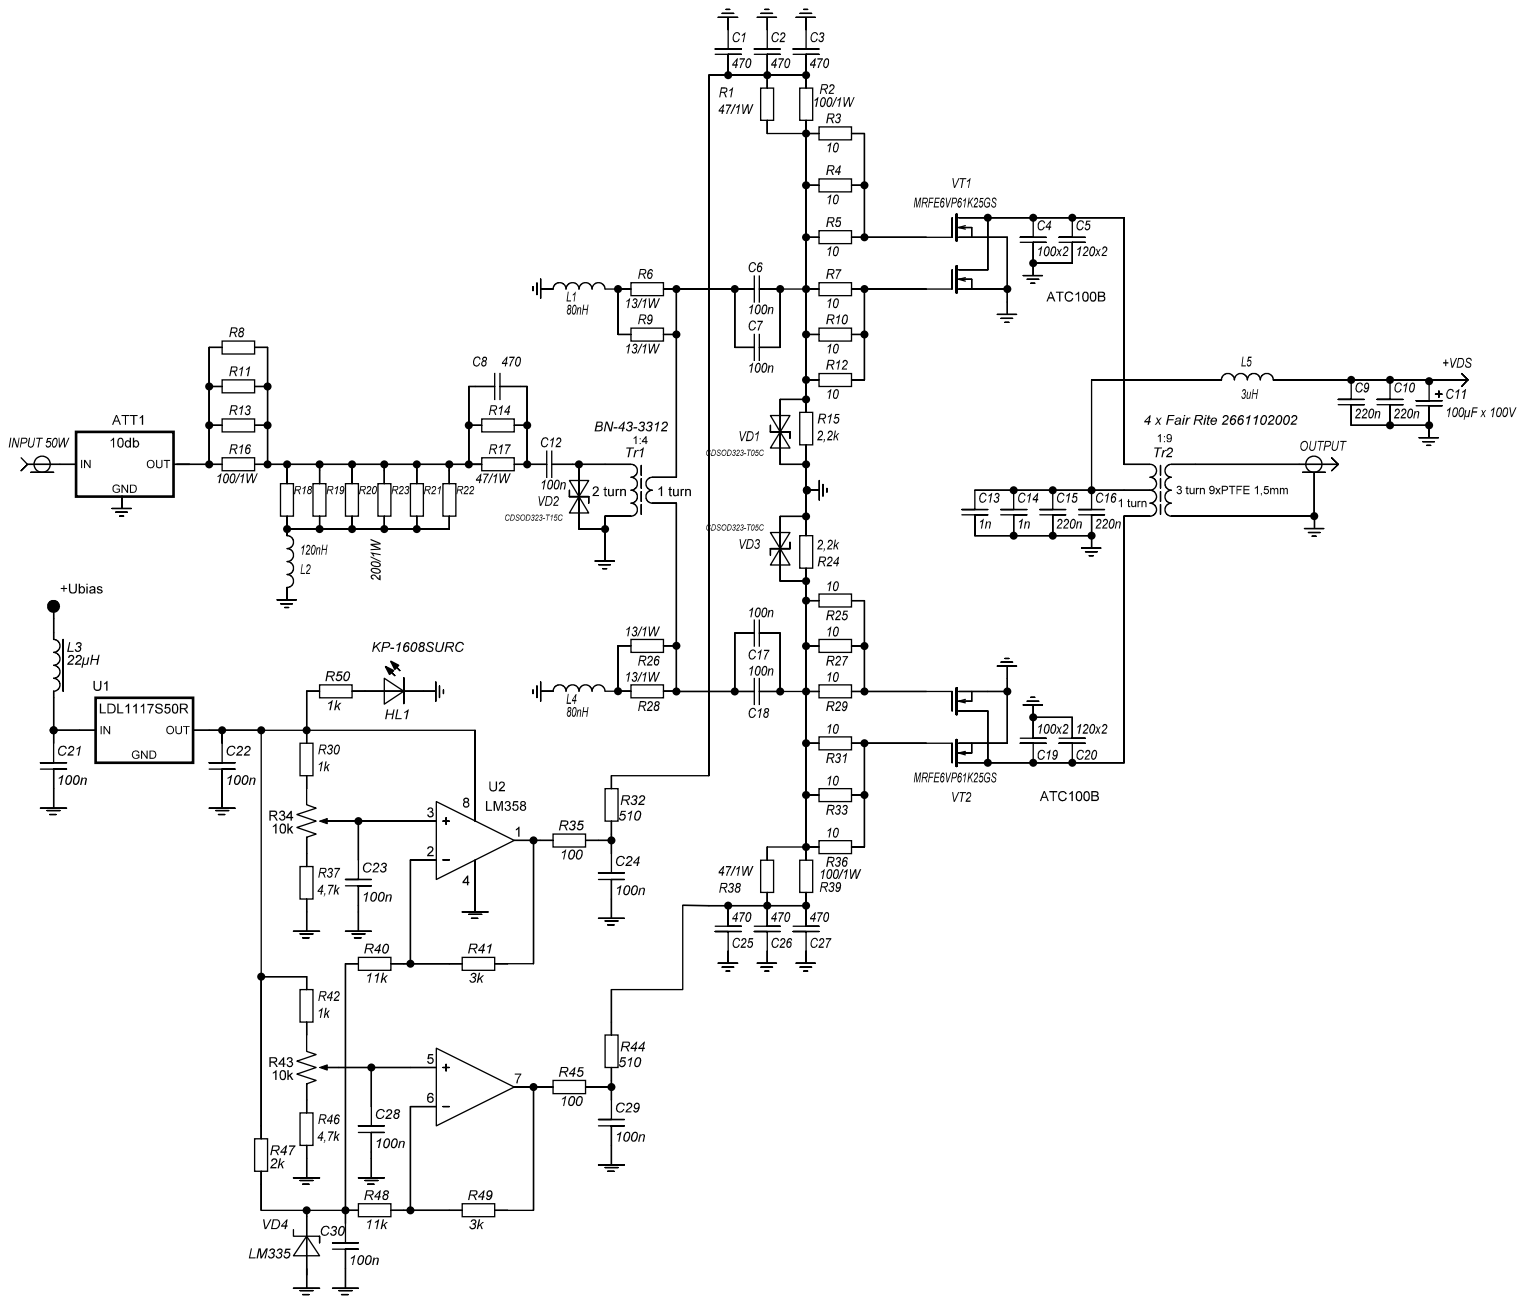
[picture p5: page 1]
