Gennady-Kudinov/PA-EW3MM-1kw-TUNER-1kw/R3BH_Gerber УМ/lpf_K25_E ver1.pdf

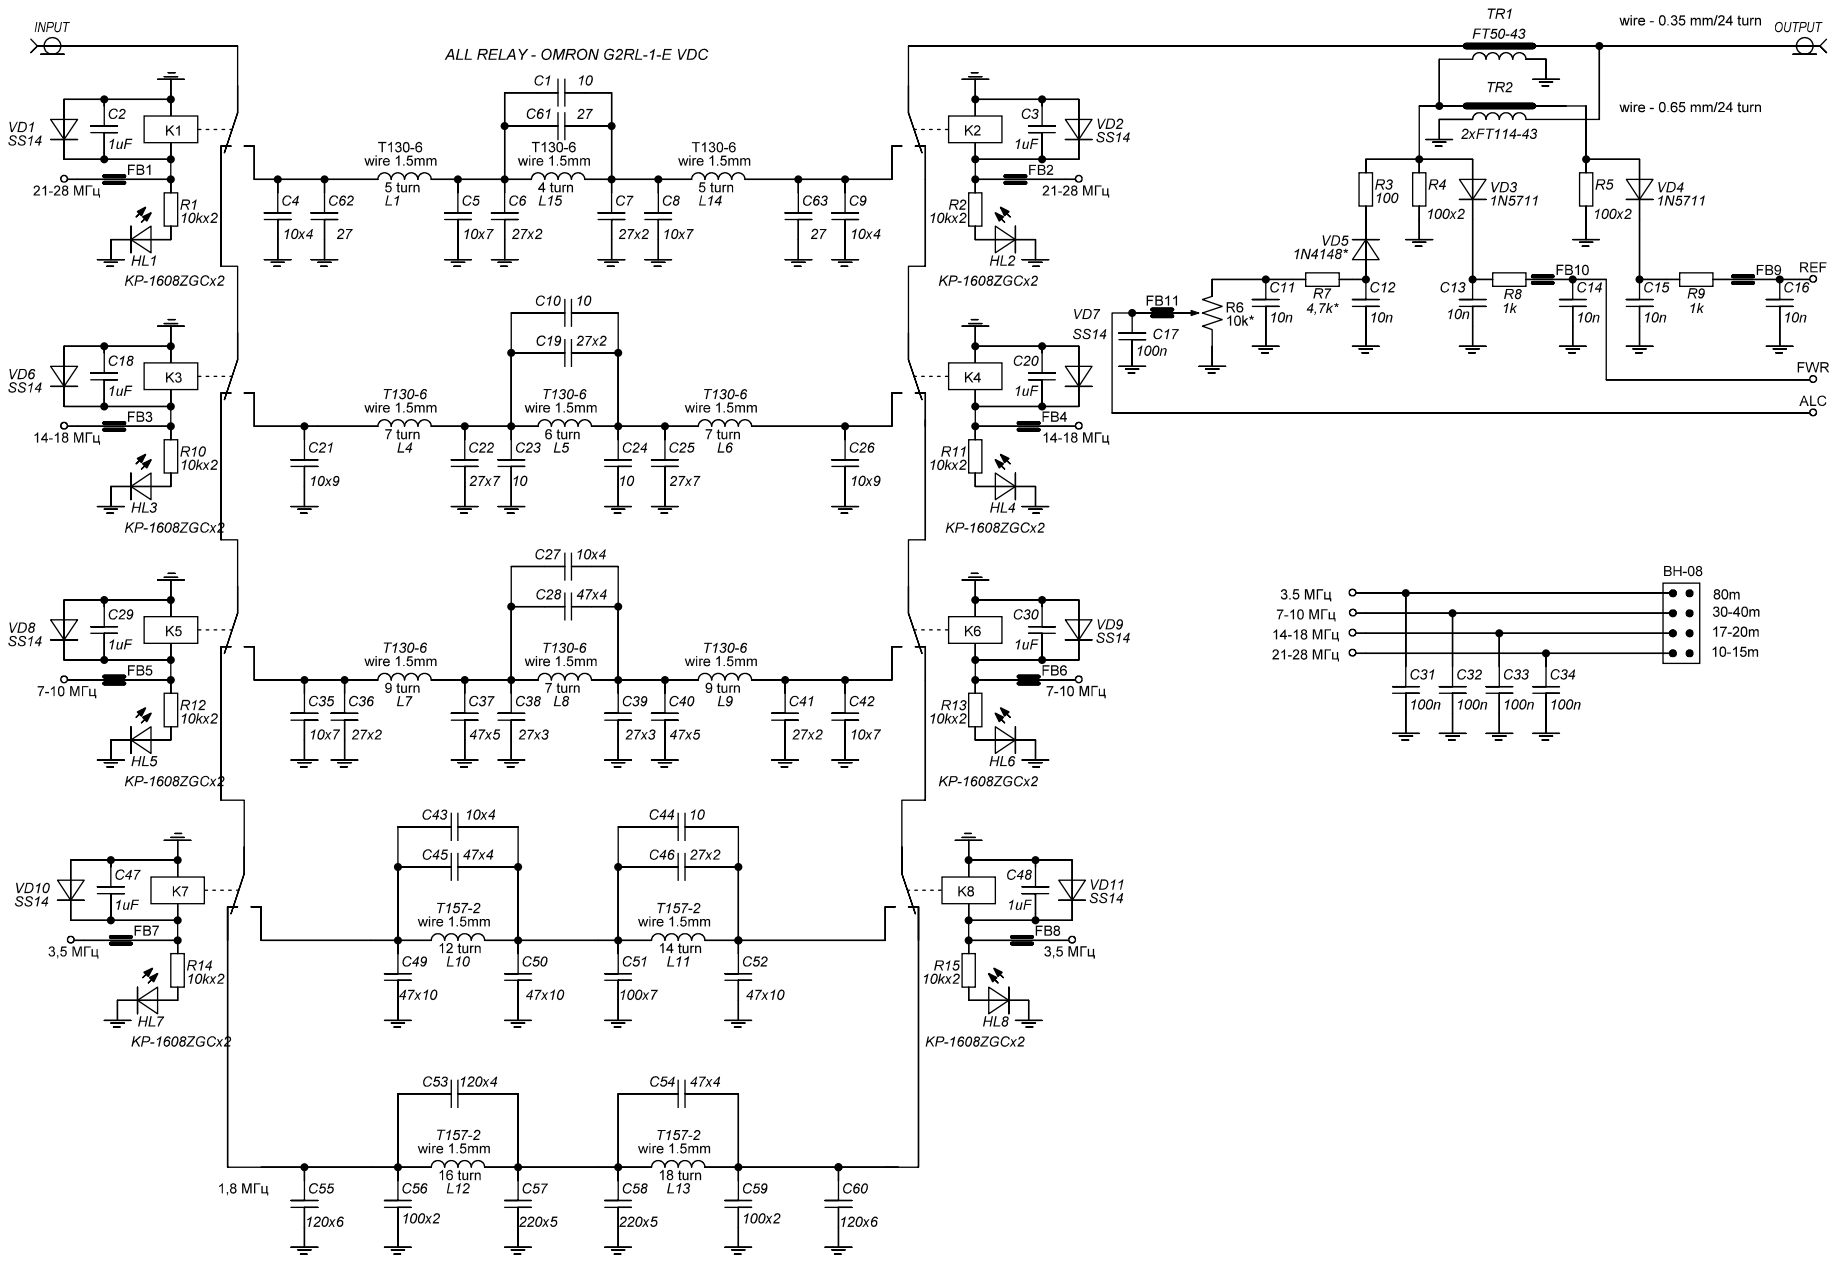
[picture p6: page 1]
