Gennady-Kudinov/PA-EW3MM-1kw-TUNER-1kw/R3BH_Gerber УМ/Relays In-Out.pdf

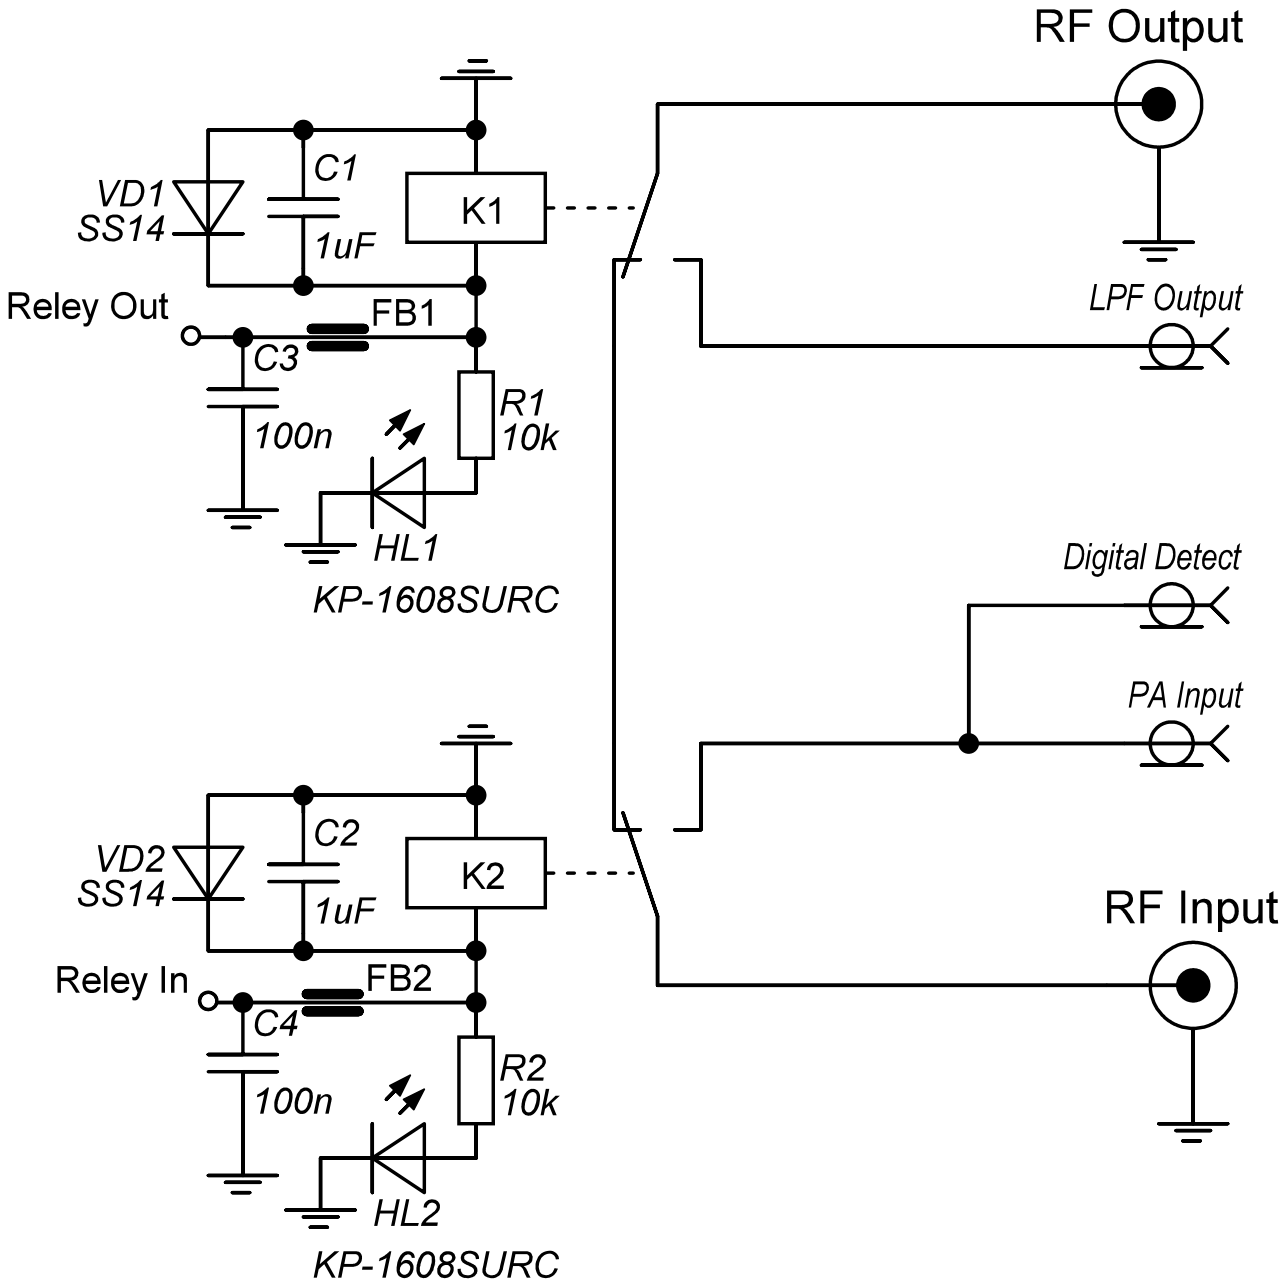
[picture p7: page 1]
