Gennady-Kudinov/PA-EW3MM-1kw-TUNER-1kw/R3BH_Gerber УМ/Tuner.pdf

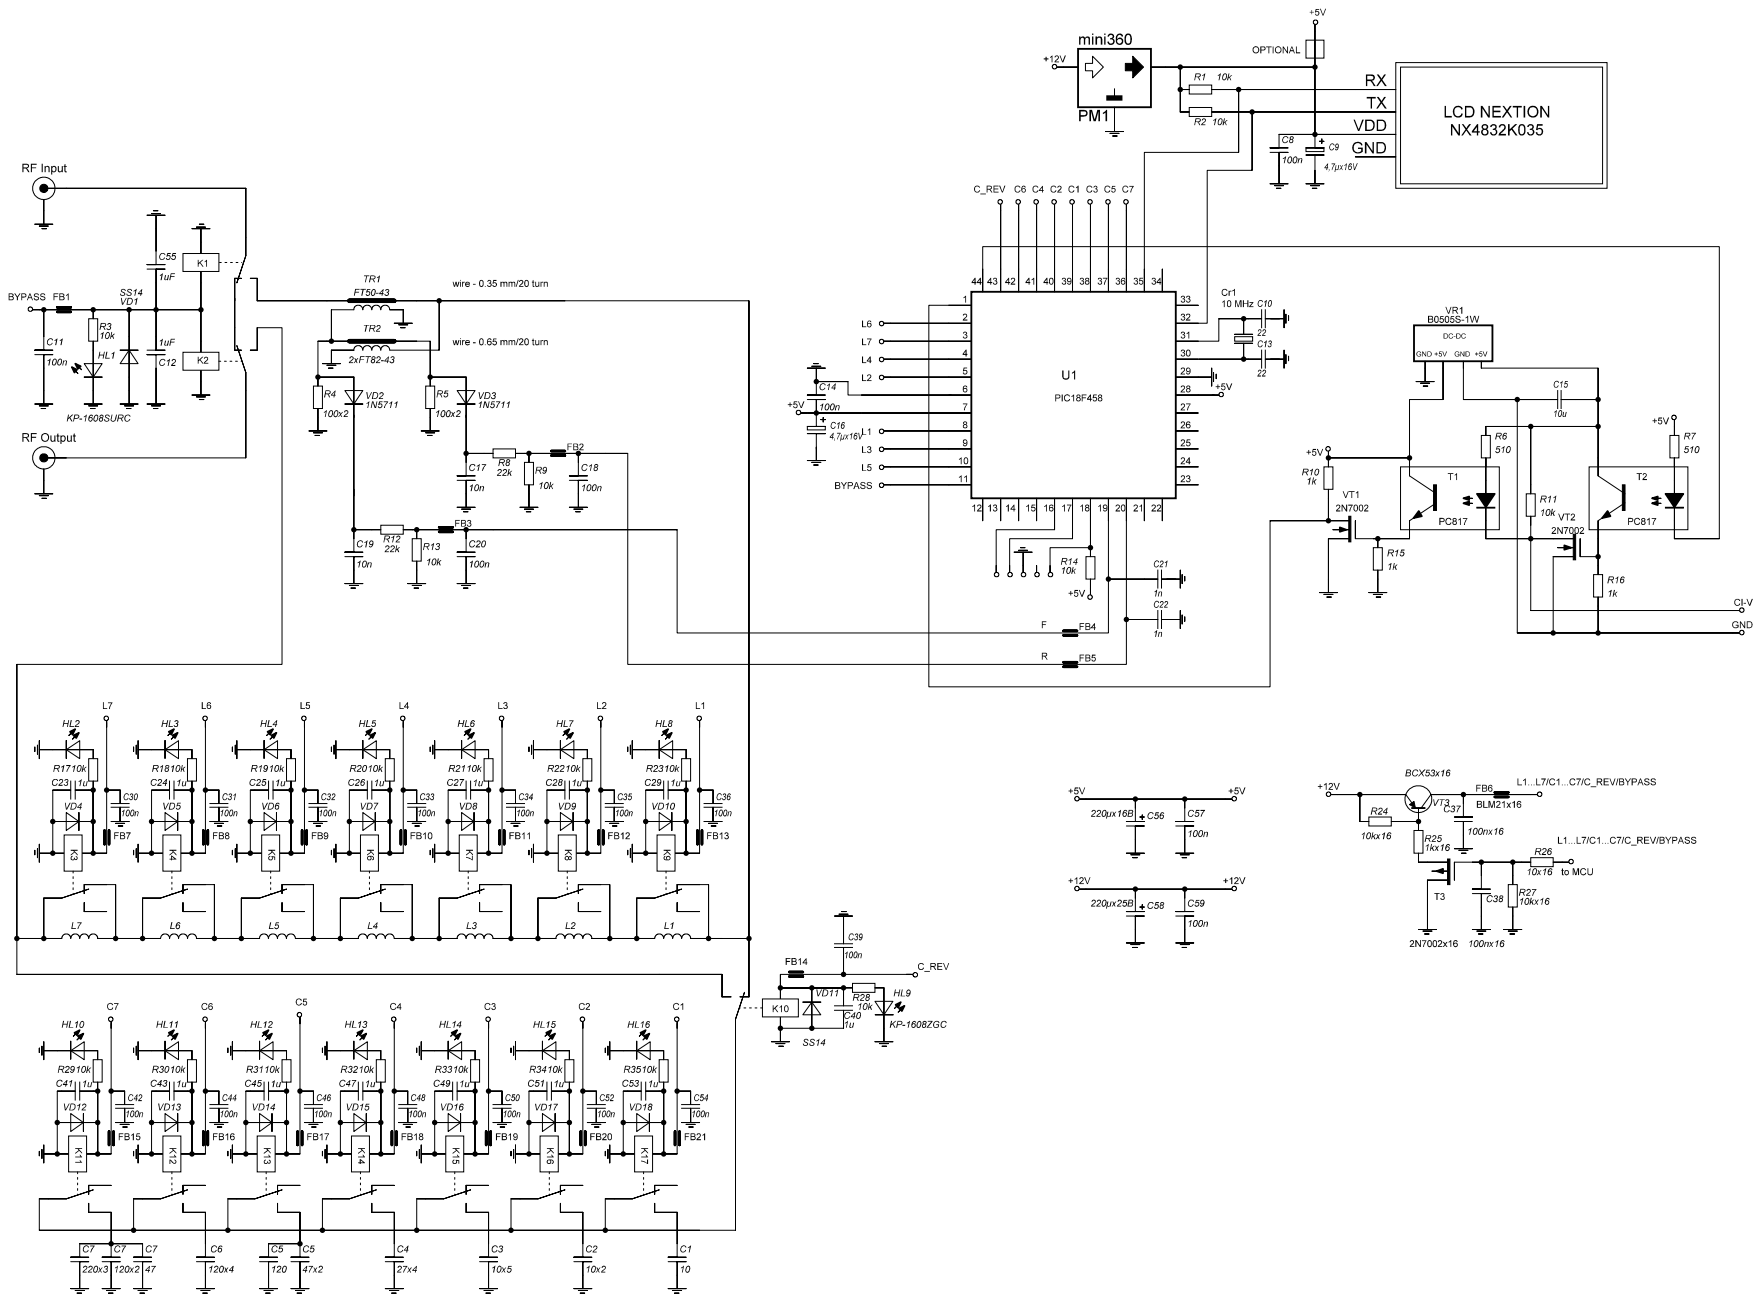
[picture p8: page 1]
