Gennady-Kudinov/PA-EW3MM-1kw-TUNER-1kw/R3BH_Gerber УМ/БП PA ver1.pdf

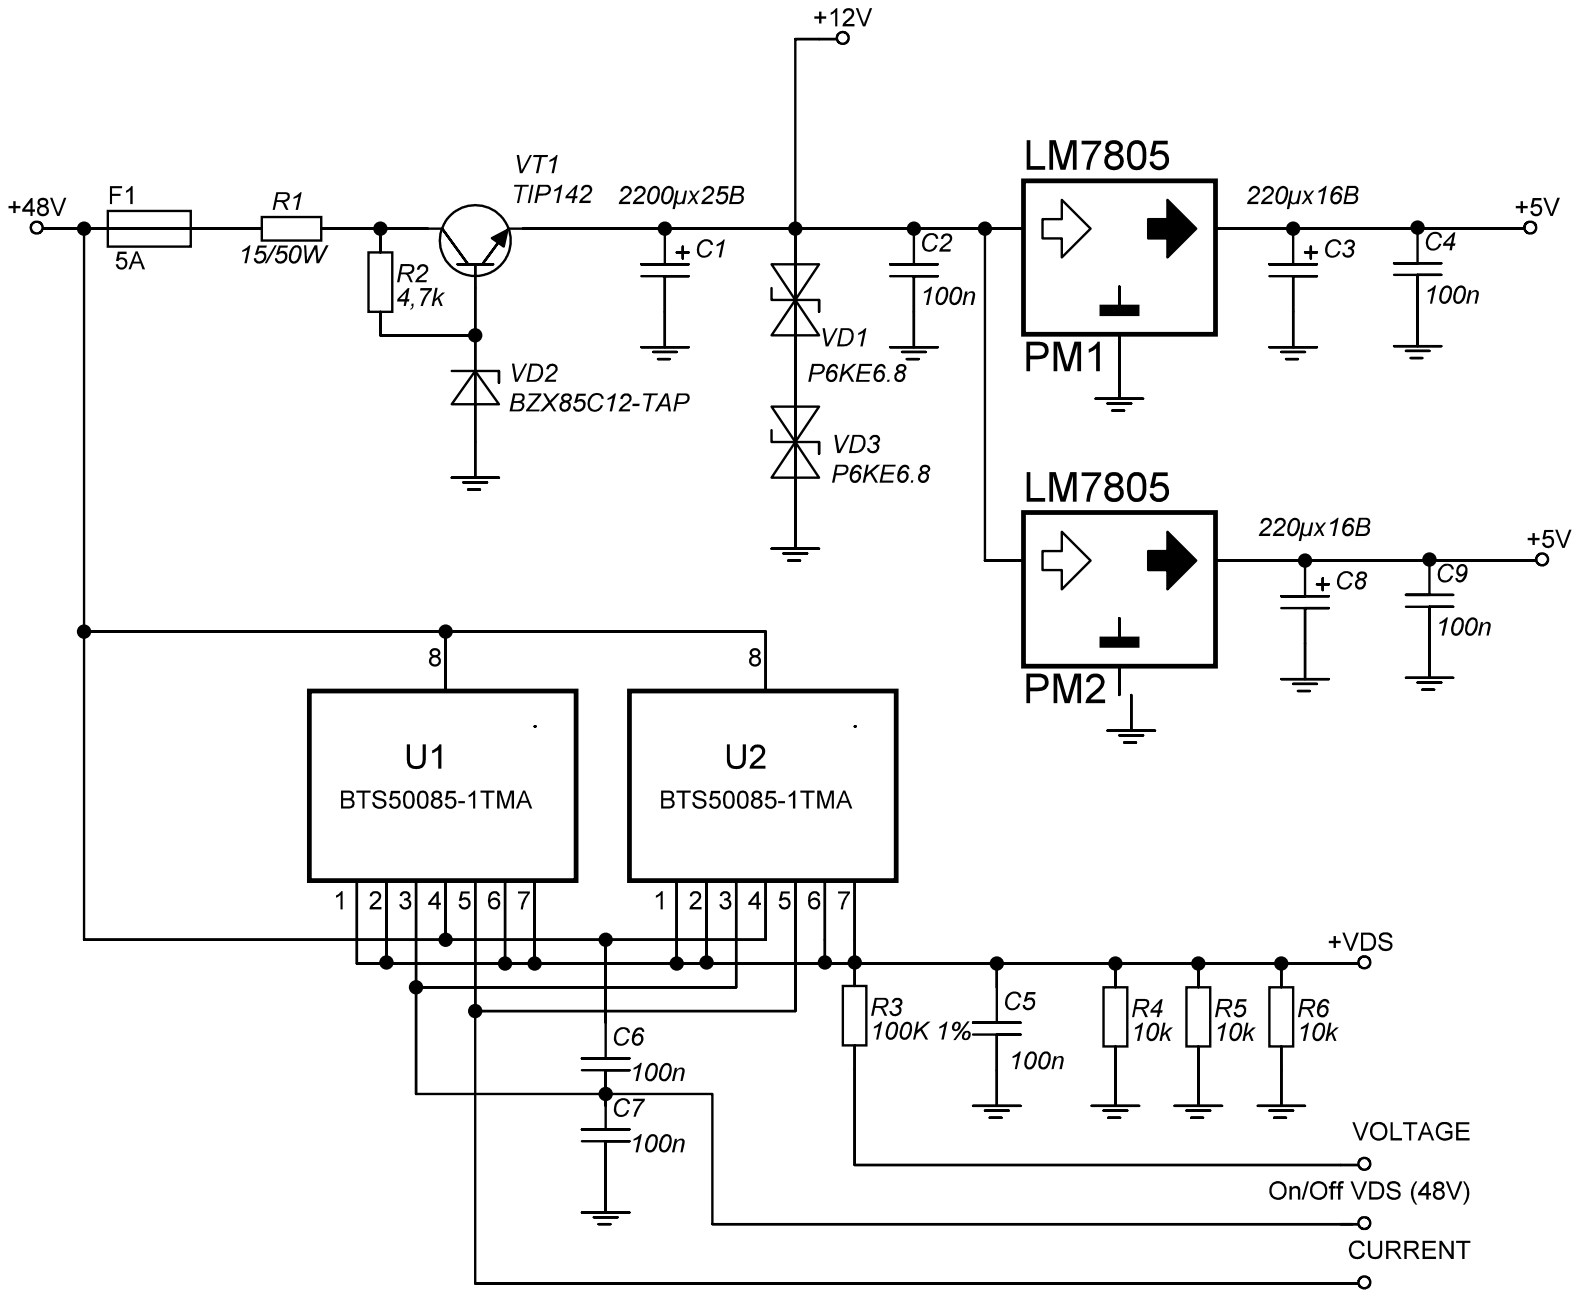
[picture p9: page 1]
