Gennady-Kudinov/PA-EW3MM-1kw-TUNER-1kw/(list of files, drawings)

Other design files:
UA4HNU_version/pic18f458_X_8.1_UA4HNU/controll_UA4HNU_2ant_50_54мгц 111.lay6
