Gennady-Kudinov/PA-EW3MM-1kw-TUNER-1kw/UA4HNU_version/pic18f458_X_8.1_UA4HNU/macros.h

//*********************************************************************************
#define UCHAR		unsigned char
#define SCHAR		signed char
#define UINT		unsigned int
#define SINT		signed int
#define ULONG		unsigned long
#define SLONG		signed long
#define FLOAT		float
#define DOUBLE		double
//*********************************************************************************
#define _NOP			asm("nop")
#define _WDT_RESET 		asm("clrwdt")
#define _FULL_RESET		asm("reset")
//*********************************************************************************
#define _MAX_USART_RX	10
#define _MAX_USART_TX	64
//*********************************************************************************
#define _ANT1                   LATDbits.LD6
#define _ANT2                   LATDbits.LD5
//
#define _PTT_INPUT		PORTAbits.RA4
//
#define _RELAY_INPUT            LATCbits.LC4
#define _RELAY_OUTPUT           LATBbits.LB3
#define _BIAS			LATEbits.LE2
#define _POWER_VDS		LATEbits.LE1
//
#define _BAND_18		LATCbits.LC2
#define _BAND_35		LATCbits.LC3
#define _BAND_70		LATDbits.LD0
#define _BAND_1014		LATDbits.LD1
#define _BAND_1821		LATDbits.LD2
#define _BAND_2428		LATDbits.LD3
#define _BAND_50		LATDbits.LD7
//
#define _FAN_SPEED		LATCbits.LC1
#define _BEEPER			LATCbits.LC5
//*********************************************************************************
#define _PWR_COEFF      870
#define _MIN_FRWD_HOLD  550 //300W
//*********************************************************************************
#define _EE_PWR		0
#define _EE_REF		2
#define _EE_CUR		4
#define _EE_VOL		6
#define _EE_TMP		8
#define _EE_TFN		10
#define _EE_LPF_P   12
#define _EE_LPF_C   14
//
#define _EE_LPF_R   16
#define _EE_HOLD    17
#define _EE_HYSTT   18
#define _EE_HYSTF   19
#define _EE_RDEL    20
#define _EE_BDEL    21
#define _EE_SENS    22
#define _EE_FPTT    23
#define _EE_BEEP    24
#define _EE_LOGO    25
//
#define _EE_BAND	26
#define _EE_ABAND	27
#define _EE_BYPASS  28
#define _EE_ANT     29
//*********************************************************************************
#define _ERROR_PWR	0x01
#define _ERROR_REF	0x02
#define _ERROR_CUR	0x04
#define _ERROR_PTT  0x08
#define _ERROR_LPF	0x10
#define _ERROR_TMP	0x20
#define _ERROR_VOL	0x40
//*********************************************************************************
#define _PAGE_MAIN  0xA0
#define _PAGE_LOGO  0xA1
#define _PAGE_SETUP 0xA2
//*********************************************************************************
