Gennady-Kudinov/PA-EW3MM-1kw-TUNER-1kw/(commit log)

2025-04-02 Gerber files full project
2025-04-03 1 kW power ampl program for a display from Nextion
    This folder contains an open source project of a 1 kW power amplifier program for a display from Nextion/
    Make changes that will improve the project. Don't forget to add changes for other users.
2025-04-03 Open source project of controller peak18f458 1kw
    Make changes and don't forget to share with others
    [protectx.X.production.obj]
2025-04-03 Gerber SWR Metr EW2DZ
2025-04-04 Rename Gerber pcb.rar to Gerber pcb_EW3MM_EW2DZ.rar
2025-04-11 проект и прошивка для тюнера 600вт
2025-04-15 5 вариантов софта емкостного дисплея, для PA 1kw.
    тут 5 вариантов софта для емкостного дисплея УМ 1квт.
    Во всех софтах следующие параметры настроек:
    Шкала FWD - мин 300вт, максимум 1200вт.
    Шкала RWD - мин 50вт, максимум 200вт.
    Шкала установок ограничения потребления тока - мин 15а, максимум 42а.
    Шкала установок ограничения питающего напряжения - мин 24в, максимум 56в.
    В каждом из вариантов отличаетс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
